deltagreg/OPEN-DELTA/photos/3D Printer 065.JPG

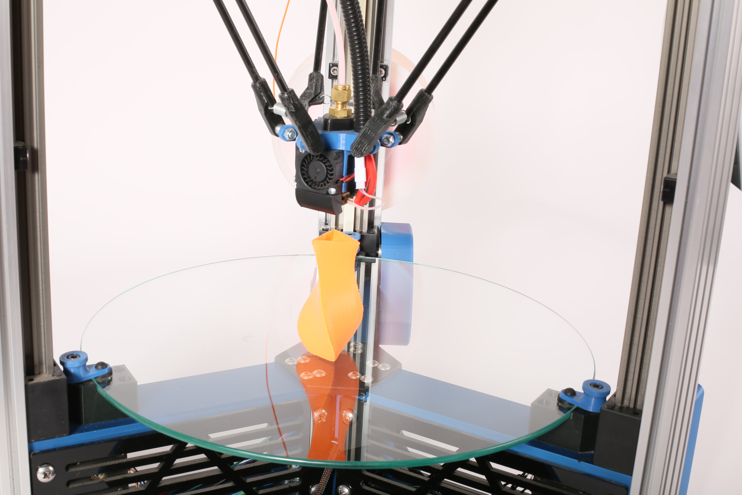
photos/3D Printer 065.JPG
