deltagreg/OPEN-DELTA/photos/3D Printer 059.JPG

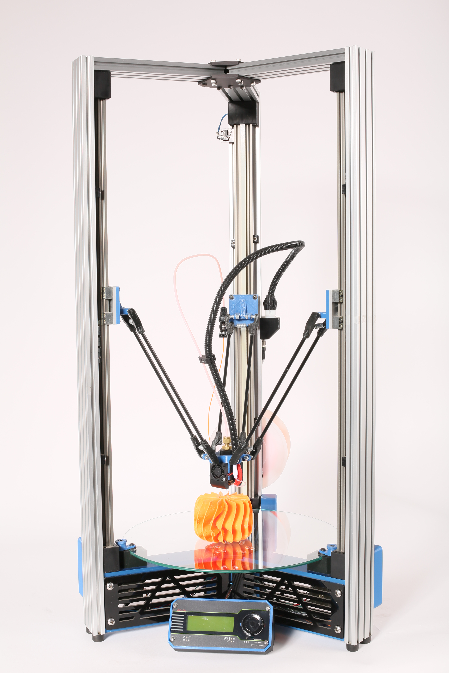
photos/3D Printer 059.JPG
