deltagreg/OPEN-DELTA/README.md

# OPEN-DELTA
DELTA 3D PRINTER 
This is the work of Greg Southerland of TX-RX Labs of Houston. Greg along with a small work group have designed and built a 3-D
printer. This work is being  given to the 3-D Printing community.
