deltagreg/OPEN-DELTA/render/delta_bot_firstPass_4_DOF_beuty0005.JPG

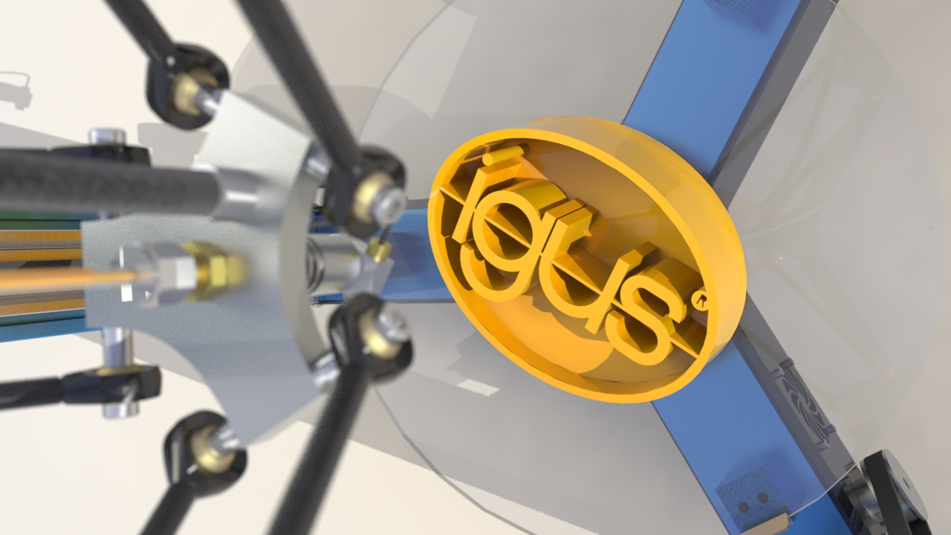
render/delta_bot_firstPass_4_DOF_beuty0005.JPG
