deltagreg/OPEN-DELTA/OPEN SOURCE PRINTER REV_1.xls

Sheet: HARDWARE
 | PARTS
 | DISCRIPTION | SOURCE | PART NUMBER | QT'Y | COMMENTS
MCMASTER-CARR NUMBER
FRAME
LEGS TO BASE MOUNTING SCREW | 5MM X 8MM SOCKET HEAD | MCMASTER-CARR | 91274A103 | 12
LEGS TO BASE MOUNTING NUT | 5MM T-NUT | MISUMI | HNKK5 | 12
TOP FROG TO TOP SCREW | 5MM X 8MM SOCKET HEAD | MCMASTER-CARR | 91274A103 | 18
TOP FROG TO TOP NUT | 5MM T-NUT | MISUMI | HNKK5 | 18
BTM FROG TO TOP SCREW | 5MM X 15MM SOCKET HEAD SCREW | MCMASTER-CARR | 91290A231 | 18
BTM FROG TO TOP NUT | 5MM LOCKNUT | MCMASTER-CARR | 94205A240 | 18
GUIDE PIN | 6MM X 2MM X 3MM DIA. SPACER | MCMASTER-CARR | 94669A700 | 6
GUIDE PIN SCREW | 3MM X 8MM SOCKET HEAD | MCMASTER-CARR | 91274A103 | 6
GUIDE PIN NUT | 3MM LOCK NUT | MCMASTER-CARR | 90576A102 | 6
TOP EXT TO SIDE EXT SCREW | 5MM X 8MM BUTTON HEAD SOCKET CAP SCREW | MCMASTER-CARR | 92137A412 | 6
SIDE PLATE H/WARE TOWARD CENTER | THREAD CERT 1/4"-1/4" THICK | MCMASTER-CARR | 93482A721 | 12
SIDE PLATE H/WARE AWAY FROM CENTER | THREAD CERT 1/4"-1/8" THICK | MCMASTER-CARR | 93482A691 | 12
SIDE TO BASE SCREW | 1/4-20X 3/4" | MCMASTER-CARR | 98164A213 | 24
FEET | 3/4" DIA X 9/16 TALLX 3/16 HOLE | MCMASTER-CARR | 9540K663 | 6
FEET MOUNTING SCREWS | 5MM X 12MM PAN HEAD | MCMASTER-CARR | 91239A228 | 6
RAIL MOTOR
MOTOR MOUNTING H/WARE | 3MM X 6MM SOCKET HEAD | MCMASTER-CARR | 91239A111 | 12
PULLEY | GT2-20 5MM BORE FLANGED 6MM WIDE | EBAY |  | 3
BELT | GT2-97 TOOTH 6MM WIDE | MUSIMI USA |  | 3
LINEAR RAIL
WHEEL AXIALS | 5MM X 30MM PAN HEAD | MCMASTER-CARR | 91239A236 | 9
WHEEL CENTER SPACERS | 5MM ID 10MM OD X 1MM THK SHIM | MCMASTER-CARR | 98089A375 | 9
WHEEL TO CARRIAGE SPACER | 5MM ID 10MM OD X 1MM THK SHIM | MCMASTER-CARR | 98089A375 | 9
WHEEL BEARINGS | FLANGED BEARING | EBAY | F605ZZ | 18
BELT CLIP SCREWS | 3MM X 12MM SOCKET HEAD | MCMASTER-CARR | 91290A117 | 12
BELT CLIP NUTS | 3MM NUT | MCMASTER-CARR | 91828A211 | 12
WHEEL TENSION ADJUSTMENT SCREW | 3MM X 25MM SOCKET HEAD | MCMASTER-CARR | 91290A125 | 3
WHEEL TENSION ADJUSTMENT NUT | 3MM SQUARE NUT |  |  | 3
IDLER BEARING | FLANGED BEARING F625ZZ | EBAY | F625ZZ | 6
IDLER SHAFT | 5MMX 50MM | MCMASTER-CARR | 6112K37 | 3
DRIVE SHAFT | 5MMX 70MM | MCMASTER-CARR | 6112K37 | 3
DRIVE PULLEY | GT2-36 5MM BORE FLANGED 6MM WIDE | EBAY |  | 3
CARRIAGE BELT PULLEY | GT2-26 5MM BORE FLANGED 9MM WIDE | MISUMI | GPA26GT2090-A-H5 | 3
BELT | GT2-1800 9MM WIDE | EBAY |  | 3
SPRING FOR BELT TENSION | SPRING #89U 7/16 OD, 3/4 LG, .048DIA wire | SERVALITE | hillman group | 2
RAIL | NFSF5-2040-798MM | MISUMI |  | 3
RAIL MOUNTING | 5MMX 12MM SOSKET HEAD | MCMASTER-CARR | 91290A228 | 12
RAIL T0 SIDE | 5MM X 35MM SOCKET HEAD | MCMASTER-CARR | 91239A256 | 12
T-NUTS | 5MM T-NUT | MISUMI | HNKK5 | 12
BEARING | 14MM x 5MM x 5MM BORE | EBAY |  | 9
PLANCHETTE
J-HEAD | J-HEAD | HOTENDS.COM | MK-V BV | 1 | DRILL 3MM HOLE FOR THERMISTER
J-HEAD /BT MOUNTING H/WARE SCREW | 3MM X 25 SOCKET HEAD | MCMASTER-CARR | 91290A125 | 2
J-HEAD /BT MOUNTING H/WARE NUT | 3MM LOCK NUT | MCMASTER-CARR | 90576A102 | 2
BOWDEN TUBE FITTING | 4MM BULKHEAD TUBE FITTING MODIFIED | SWEDGELOK | BB-4MO-61 | 1 | CUT TO 27mm total length
FILAMENT FAN MOUNTING H/WARE | 2.9MM X 6.5MM #1 DRIVE | MCMASTER-CARR | 94997A225 | 8
BARREL FAN MOUNTING H/WARE | 2.9MM X 13MM #1 DRIVE | MCMASTER-CARR | 94997A275 | 4
BOWDEN TUBE | 4MM X DDDMM | EBAY |  |  | 30"
ELECT TUBE | 3/8" CORRUGATED TUBING .5" OD | MCMASTER-CARR | 7840K72 | 5'? | CUT TO 30"
ARMS
SPRINGS | SPRING #74 5/16 OD, 1-3/16 LG,.035DIA | SERVALITE | hillman group | 12 | ebay
ARM RODS | CARBON FIBER SPAR .24"DIA 32.5" LNG | GOODWINS.COM | 20010 | 2 | CUT TO 260MM
BALL STUD | 5MM THREAD BALL STUD 8MM DIA BALL | SPRINGFIX LINKAGES | M 2662 | 12
BALL STUD MOUNTING H/WARE | 5MM LOCKNUT | MCMASTER-CARR | 94205A240 | 12
HOME SWITCHES
MOUNTING HARDWARE | 5MM X 10MM SOCKET HEAD SCREW | MCMASTER-CARR | 91290A224 | 3
CIRCUIT BOARD MOUNTING H/WARE SCREW | 3MM X 8MM SOCKET HEAD SCREW | MCMASTER-CARR | 91290A113 | 3
CIRCUIT BOARD MOUNTING H/WARE THREAD CERT | 3MM THREAD CERT 3.8MM LNG | MCMASTER-CARR | 94180A331 | 3
GLASS HOLD DOWN (FSR)
HINGE AXIAL | 5MM X 35MM SOCKET HEAD SCREW | MCMASTER-CARR | 91290A256 | 3
AXAL NUT | 5MM LOCKNUT | MCMASTER-CARR | 94205A240 | 3
BUMPER
BUMPER SCREW | 5MM X 15MM SOCKET HEAD SCREW | MCMASTER-CARR | 91274A125 | 3
BUMPER NUT | 5MM LOCKNUT | MCMASTER-CARR | 94205A240 | 3
CAM SPACER | 5MM ID 8MM OD 8MM LG | MCMASTER-CARR | 93295A551 | 3
CAM AXAIL | 5MM X 18MM SOCKET HEAD SCREW | MCMASTER-CARR | 91290A238 | 3
MOUNTING H/WARE SCREW | 5MM X 15MM SOCKET HEAD SCREW | MCMASTER-CARR | 91274A125 | 6
MOUNTING H/WARENUT | 5MM LOCKNUT | MCMASTER-CARR | 94205A240 | 6
POWER SUPPLY/SWITCH
SWITCH MOUNTING H/WARE | 4MM X 5MM SOCKET HEAD SCREW | MCMASTER-CARR | 91274A113 | 2
END CAP MOUNTING H/WARE | 4MM X 5MM SOCKET HEAD SCREW | MCMASTER-CARR | 91274A113 | 2
RETAINER SCREWS | 3MM X 16MM SOCKET HEAD SCREW | MCMASTER-CARR | 95263A158 | 2
RETAINER NUTS | 3MM LOCK NUT | MCMASTER-CARR | 90576A102 | 2
SWITCH SCREWS | 4MM X 8MM FLAT HEAD SCREW | MCMASTER-CARR | 91263A827 | 2
SWITCH NUTS | 4MM LOCK NUT | MCMASTER-CARR | 90576A103 | 2
FEET SCREWS | 5MM X 15MM SOCKET HEAD SCREW | MCMASTER-CARR | 91274A125 | 4
NUT CERT | 5MM THREAD CERT | MCMASTER-CARR | 94180A361 | 2
PRINTER SWITCH
PLUG MOUNTING H/WARE | 2.9MM X 6.5MM #1 DRIVE | MCMASTER-CARR | 94997A225 | 2
CASE MOUNTING H/WARE TOP SCREWS | 5MM X 8MM SOCKET HEAD | MCMASTER-CARR | 91274A103 | 2
CASE MOUNTING H/WARE BTM SCREW | 5MM X 30MM SOCKET HEAD | MCMASTER-CARR | 91290A254 | 1
CASE MOUNTING T-NUT | 5MM T-NUT | MISUMI | HNKK5 | 3
ELECTRONICS
E BOARD SPACER TO SIDE PLATE SCREW | 3MM X 5MM SOCKET HEAD | MCMASTER-CARR | 91274A101 | 4
THREADED SPACER | 3MM X 6MM ALUM. THREADED SPACER | MCMASTER-CARR | 95947A110 | 4
E BOARD MOUNTING TO SPACER SCREW | 3MM X 4MM PAN HEAD | MCMASTER-CARR | 92000A113 | 4
DISPLAY
CASE MOUNTING H/WARE SCREW | 5MM X 8MM SOCKET HEAD | MCMASTER-CARR | 91274A103 | 2
CASE MOUNTING THREAD CERT | 5MM THREAD CERT | MCMASTER-CARR | 94180A361 | 2
DISPLAY MOUNTING H/WARE | 2.9MM X 6.5MM #1 DRIVE | MCMASTER-CARR | 94997A225 | 4 | MODIFY FOR 3MM THRD CERT?
ELECT TUBE | 3/8" CORRUGATED TUBING .5" OD | MCMASTER-CARR | 7840K72 |  | CUT TO 100mm
FILAMENT FEEDER
MOUNTING H/WARE SCREW | 5MM X 8MM SOCKET HEAD | MCMASTER-CARR | 91274A103 | 2
MOUNTING H/WARE T-NUT | 5MM T-NUT | MISUMI | HNKK5 | 2 | openbuilds $ .20
SPRING | .375 OD X 1" .035 DIA | MCMASTER-CARR | 9657K306 | 1
KNOB | 1/16-18 BRASS THUMB NUT | MCMASTER-CARR | 92741A170 | 1
ADJUSTMENT SCREW | 5/16-18 1-1/2"LG CAP SCREW | MCMASTER-CARR | 91309A587 | 1
MK-7 KNURLED GEAR | MK-7 F- DRIVE GEAR 5MM BORE 1.75 | EBAY |  | 1 | $3.70
MOTOR MOUNTING BOLTS | 3MM X 30MM LG | MCMASTER-CARR | 91290A130 | 4
BEARING | 16MM X 5MM BORE 5MM THICK | EBAY | 605ZZ | 1
BEARING AXAL | 5MM X 12MM | MCMASTER-CARR | 91290A228 | 1
AXAL NUT | 5MM T-NUT | MISUMI | HNKK5 | 1
BEARING SPACERS | 5MM ID 10MM OD X 1MM THK SHIM | MCMASTER-CARR | 98089A375 | 2
HOTEND PLUG
PLUG BOX MOUNTING H/WARE SCREW | 5MM X 8MM SOCKET HEAD | MCMASTER-CARR | 91274A103 | 2
PLUG BOX MOUNTING H/WARE T-NUT | 5MM T-NUT | MISUMI | HNKK5 | 2
CONDUIT HEADSHELL SCREW | 3MM X 6MM SOCKET HEAD SCREW | MCMASTER-CARR | 91239A111 | 2
CONDUIT HEADSHELL NUT | 3MM NUT | MCMASTER-CARR | 91828A211 | 2
BELT GUARD
MOUINTING SCREWS | 5MM X 8MM SOCKET HEAD | MCMASTER-CARR | 91274A103 | 6
MOUNTING H/WARE T-NUT | 5MM T-NUT | MISUMI | HNKK5 | 6
REEL HOLDER
MOUINTING SCREWS | 5MM X 8MM SOCKET HEAD | MCMASTER-CARR | 91274A103 | 2
MOUNTING H/WARE T-NUT | 5MM T-NUT | MISUMI | HNKK5 | 6
 | McMASTER CARR |  |  | REQ'D/1 | QT'Y PER UNIT | COST/UNIT | GROSS UNITS/# OF PEOPLE | TOTAL COST
 | 1/4-20X 3/4" SOCKET HEAD SCREW | MCMASTER-CARR | 98164A213 | 24 | 25 | 9.81 | 8 | 78.48
 | 2.9MM X 13MM #1 DRIVE | MCMASTER-CARR | 94997A275 | 4 | 100 | 12.34 | 1 | 12.34
 | 2.9MM X 6.5MM #1 DRIVE | MCMASTER-CARR | 94997A225 | 14 | 100 | 11.8 | 2 | 23.60
 | 3/8" CORRUGATED TUBING .5" OD | MCMASTER-CARR | 7840K72 | 0 | 5' | 2.52 | 8 | 20.16
 | 3MM LOCK NUT | MCMASTER-CARR | 90576A102 | 10 | 100 | 3.27 | 1 | 3.27
 | 3MM NUT | MCMASTER-CARR | 91828A211 | 14 | 100 | 5.55 | 2 | 11.10
 | 3MM THREAD CERT 3.8MM LNG | MCMASTER-CARR | 94180A331 | 3 | 100 | 12.3 | 1 | 12.30
 | 3MM X 4MM PAN HEAD | MCMASTER-CARR | 92000A113 | 4 | 100 | 5.52 | 1 | 5.52
 | 3MM X 5MM SOCKET HEAD | MCMASTER-CARR | 91274A101 | 4 | 50 | 4.35 | 1 | 4.35
 | 3MM X 6MM SOCKET HEAD | MCMASTER-CARR | 91239A111 | 14 | 100 | 6.88 | 2 | 13.76
 | 3MM X 8MM SOCKET HEAD SCREW | MCMASTER-CARR | 91290A113 | 3 | 100 | 6.58 | 1 | 6.58
 | 3MM X 12MM SOCKET HEAD | MCMASTER-CARR | 91290A117 | 12 | 100 | 7.75 | 1 | 7.75
 | 3MM X 16MM SOCKET HEAD SCREW | MCMASTER-CARR | 95263A158 | 2 | 25 | 3.9 | 1 | 3.90
 | 3MM X 25MM SOCKET HEAD | MCMASTER-CARR | 91290A125 | 5 | 100 | 11.92 | 1 | 11.92
 | 3MM X 30MM SOCKET HEAD | MCMASTER-CARR | 91290A130 | 4 | 100 | 9.96 | 1 | 9.96
 | 4MM LOCK NUT | MCMASTER-CARR | 90576A103 | 2 | 100 | 3.9 | 1 | 3.90
 | 4MM X 5MM SOCKET HEAD SCREW | MCMASTER-CARR | 91274A113 | 4 | 50 | 6.63 | 1 | 6.63
 | 4MM X 6MM FLAT HEAD SCREW | MCMASTER-CARR | 91263A826 | 2 | 100 | 6.31 | 1 | 6.31
 | 3MM X 6MM ALUM. THREADED SPACER | MCMASTER-CARR | 95947A110 | 4 | 1 | 0.46 | 32 | 14.72
 | 5MM ID 10MM OD X 1MM THK SHIM | MCMASTER-CARR | 98089A375 | 20 | 25 | 7.21 | 7 | 50.47
 | 5MM LOCKNUT | MCMASTER-CARR | 94205A240 | 42 | 50 | 6.09 | 7 | 42.63
 | 5MM THREAD CERT | MCMASTER-CARR | 94180A361 | 2 | 50 | 11.43 | 1 | 11.43
 | 5MM X 8MM SOCKET HEAD SCREW | MCMASTER-CARR | 91274A103 | 50 | 100 | 9.55 | 4 | 38.20
 | 5MM X 10MM SOCKET HEAD SCREW | MCMASTER-CARR | 91290A224 | 3 | 100 | 9.55 | 1 | 9.55
 | 5MM X 12MM SOCKET HEAD | MCMASTER-CARR | 91290A228 | 13 | 100 | 10.98 | 2 | 21.96
 | 5MM X 15MM SOCKET HEAD SCREW | MCMASTER-CARR | 91290A231 | 18 | 100 | 14.29 | 2 | 28.58
 | 5MM X 18MM SOCKET HEAD SCREW | MCMASTER-CARR | 91290A238 | 3 | 100 | 12.45 | 1 | 12.45
 | 5MM X 30MM PAN HEAD | MCMASTER-CARR | 91239A236 | 9 | 100 | 12.38 | 1 | 12.38
 | 5MM X 30MM SOCKET HEAD | MCMASTER-CARR | 91290A254 | 1 | 50 | 7.99 | 1 | 7.99
 | 5MM X 35MM SOCKET HEAD | MCMASTER-CARR | 91290A256 | 3 | 10 | 10 | 3 | 30.00
 | 5MM X 50MM SHAFT | MCMASTER-CARR | 6112K37 | 6 | 200mm long | 9.02 | 8 | 72.16
 | 5MM X 12MM PAN HEAD | MCMASTER-CARR | 91239A228 | 6 | 100 | 8.12 | 1 | 8.12
 | 5MM ID 8MM OD 8MM LG | MCMASTER-CARR | 93295A551 | 3 | 1 | 1.38 | 24 | 33.12
 | 6MM OD. X 2MM X 3MM ID. SPACER | MCMASTER-CARR | 94669A700 | 6 | 1 | 1.23 | 48 | 59.04
 | THREAD CERT 1/4"-1/4" THICK | MCMASTER-CARR | 93482A721 | 12 | 25 | 8.54 | 4 | 34.16
 | THREAD CERT 1/4"-1/8" THICK | MCMASTER-CARR | 93482A691 | 12 | 25 | 7.53 | 4 | 30.12
 | 1/16-18 BRASS THUMB NUT | MCMASTER-CARR | 92741A170 | 1 | 25 | 7.53 | 1 | 7.53
 | 5/16-18 1-1/2"LG CAP SCREW | MCMASTER-CARR | 91309A587 | 1 | 25 | 7.53 | 1 | 7.53
 |  |  |  |  |  |  | NUMBER OF PEOPLE | PER PERSON
 |  |  |  |  |  |  |  | 613.98
 |  |  |  |  |  |  | 8 | 76.75
 | MISUMI
 | 5MM T-NUT | MISUMI | HNKK5 | 56 | 100 | 20.87 | 20.87
 | LEGS | MISUMI | HFS5-2060-1000 | 3 | 1 | 12.9 | 38.7
 | LINEAR RAIL | MISUMI | HFSF5-2040-800 | 3 | 1 | 9.92 | 29.76
 | TOP | MISUMI | HFS5-2060-225 | 3 | 1 | 3.85 | 11.55
 |  |  |  |  |  |  | 100.88
 | EBAY
 | GT2-20 5MM BORE FLANGED 6MM WIDE |  |  | 3
 | FLANGED BEARING | EBAY | F605ZZ | 18 |  | 0.7 | 12.6
 | FLANGED BEARING F625ZZ | EBAY | F625ZZ | 6 |  | 0.9 | 5.4
 | GT2-36 5MM BORE FLANGED 6MM WIDE | EBAY |  | 3 |  | 3.25 | 9.75
 | GT2-1800 9MM WIDE | EBAY |  | 1 | 2000MM | 10 | 10
 | 4MM X DDDMM TEFLON TUBE | EBAY |  | 1 |  | 5 | 5
 | 14MM x 5MM x 5MM BORE | EBAY | 605ZZ | 9 |  | 0.6 | 5.4
 |  |  |  |  |  |  | 48.15
 |  |  |  |  | HARDWARE | 226.00
 |  |  |  |  | LIMIT SWITCH | 30
 |  |  |  |  | MACHINE | 100
 |  |  |  |  | DISPLAY | 75
 |  |  |  |  | BOARD | 110
 |  |  |  |  | MOTORS | 80
 |  |  |  |  | FANS (4) | 40
 |  |  |  |  | HOT END | 75
 |  |  |  |  | POWER SUPPLY | 40
 |  |  |  |  | MISC ELEC | 50
 |  |  |  |  | TOTAL | 826 | 165.2
 |  |  |  |  | TOTAL + SHIPPING 20% | 991.2
 |  |  |  |  | MISC. 20% | 1156.4

Sheet: 3D PRINTED PARTS
 |  | FILE
 | QT'Y | STL | REV |  | SOLIDWORKS | REV | DXF | REV
FRAME
TOP FROG | 2 | P-FM-001_REV_0 | 0 | P-FM-001_REV_0 |  | 0 | P-FM-001_REV_0 | 0
BOTTOM FROG | 2 | P-FM-002_REV_0 | 0 | P-FM-002_REV_0 |  | 0 | P-FM-002_REV_0 | 0
LINEAR RAIL
DRIVE ENDCAP | 3 | P-LR-001_REV_0 | 0 | P-LR-001_REV_0 | DRIVE_1.SLDPRT | 0 | P-LR-001_REV_0 | 0
DRIVEN ENDCAP | 3 | P-LR-002_REV_0 | 0 | P-LR-002_REV_0 | IDLER_1.SLDPRT | 0 | P-LR-002_REV_0 | 0
CARRIAGE | 3 | P-LR-003_REV_0 | 0 | P-LR-003_REV_0 | CARRIAGE 6 .SLDPRT | 0 | P-LR-003_REV_0 | 0
IDLER SHAFT BLOCK | 3 | P-LR-004_REV_0 | 0 | P-LR-004_REV_0 | JACK BLOCK.SLDPRT | 0 | P-LR-004_REV_0 | 0
MAG HOLDER | 3 | P-LR-005_REV_0 | 0 | P-LR-005_REV_0 | MAG HOLDER.SLDPRT | 0 | P-LR-005_REV_0 | 0
BELT RETAINER | 3 | P-LR-006_REV_0 | 0 | P-LR-006_REV_0 | CLET_2 | 0 | P-LR-006_REV_0 | 0
PLANCHETTE
PLANCHETTE | 1 | P-PL-001_REV_0 | 0 | P-PL-001_REV_0 | PLANCHETTEV6.SLDPRT | 0 | P-PL-001_REV_0 | 0
J-HEAD MOUNT | 1 | P-PL-002_REV_1 | 1 | P-PL-002_REV_1 | J-HEADMOUNT_REV3.SLDPRT | 1 | P-PL-002_REV_0 | 1
ARMS
ROD ENDS | 12 | P-AM-01_REV_0 | 0 | P-AM-01_REV_0 | BS ROD.SLDPRT | 0 | P-AM-01_REV_0 | 0
HOME SWITCHES
CASE | 3 | P-HS-001_REV_0 | 0 | P-HS-001_REV_0 | LIMIT SWITCH HE.SLDPRT | 0 | P-HS-001_REV_0 | 0
GLASS HOLD DOWN
HINGE BOTTOM | 3 | P-GL-001_REV_0 | 0 | P-GL-001_REV_0 | BOTTOM GLASS.SLDPRT | 0 | P-GL-001_REV_0 | 0
HINGE TOP | 3 | P-GL-002_REV_0 | 0 | P-GL-002_REV_0 | TOP GLASS .SLDPRT | 0 | P-GL-002_REV_0 | 0
CAM | 3 | P-GL-003_REV_0 | 0 | P-GL-003_REV_0 | CAM.SLDPRT | 0 | P-GL-003_REV_0 | 0
POWER SUPPLY
END CAP W/O SWITCH | 1 | P-PS-001_REV_0 | 0 | P-PS-001_REV_0 | POWER SUPPLY NON-SWITCH.SLDPRT | 0 | P-PS-001_REV_0 | 0
END CAP W/SWITCH | 1 | P-PS-002_REV_0 | 0 | P-PS-002_REV_0 | POWER SUPPLY SWITCH.SLDPRT | 0 | P-PS-002_REV_0 | 0
STRAIN RELIEF | 1 | P-PS-003_REV_0 | 0 | P-PS-003_REV_0 | STRAIN RELIEF.SLDPRT | 0 | P-PS-003_REV_0 | 0
FEET | 1 | P-PS-004_REV_0 | 0 | P-PS-004_REV_0 |  | 0 | P-PS-004_REV_0 | 0
PRINTER SWITCH |  |  | 0
SWITCH ENCLOSURE | 1 | P-PR-001_REV_0 | 0 | P-PR-001_REV_0 | ELECT BOX_3.SLDPRT | 0 | P-PR-001_REV_0 | 0
DISPLAY
CASE | 1 | P-DS-001_REV_0 | 0 | P-DS-001_REV_0 | DISPLAY CASE.SLDPRT | 0 | P-DS-001_REV_0 | 0
BEZZEL | 1 | P-DS-002_REV_0 | 0 | P-DS-002_REV_0 | BHEZEL_2.SLDPRT | 0 | P-DS-002_REV_0 | 0
 |  |  | 0 |  |  | 0 |  | 0
FILLAMENT FEEDER |  |  | 0 |  |  | 0 |  | 0
FILLAMENT FEEDER RT SIDE | 1 | P-FF-001_REV_0 | 0 | P-FF-001_REV_0 | RIGHT PUSHER.SLDPRT | 0 | P-FF-001_REV_0 | 0
BEARING YOLK | 1 | P-FF-002_REV_0 | 0 | P-FF-002_REV_0 | YOLK PUSHER.SLDPRT | 0 | P-FF-002_REV_0 | 0
FILLAMENT FEEDER LT SIDE |  | P-FF-003_REV_0 | 0 | P-FF-003_REV_0 | PUSHER_3.SLDPRT | 0 | P-FF-003_REV_0 | 0
 |  |  | 0 |  |  | 0 |  | 0
BELT GUARD |  |  | 0 |  |  | 0 |  | 0
BELT GUARD RT | 2 | P-BG-001_REV_0 | 0 | P-BG-001_REV_0 | BELT GUARD REV.2.SLDPRT | 0 | P-BG-001_REV_0 | 0
BELT GUARD LT | 1 | P-BG-002_REV_0 | 0 | P-BG-002_REV_0 | LEFT BELT GUARD REV 2.SLDPRT | 0 | P-BG-002_REV_0 | 0
 |  |  | 0 |  |  | 0 |  | 0
REEL HOLDER |  | P-RH-001_REV_0 | 0 | P-RH-001_REV_0 | P-RH-001_REV_0 | 0 | P-RH-001_REV_0 | 0
 |  |  | 0 |  |  | 0 |  | 0
HOTEND PLUG |  |  | 0 |  |  | 0 |  | 0
MOLLEX CONNECTION BOX | 1 | P-HP-001_REV_0 | 0 | P-HP-001_REV_0 |  | 0 | P-HP-001_REV_0 | 0
HEADSHELL A | 1 | P-HP-002_REV_0 | 0 | P-HP-002_REV_0 |  | 0 | P-HP-002_REV_0 | 0
HEADSHELL B | 1 | P-HP-003_REV_0 | 0 | P-HP-003_REV_0 |  | 0 | P-HP-003_REV_0 | 0

Sheet: ELECTRONICS
 | PARTS |  | DWG |  | CIRCUIT BOARD FILES
 | DISCRIPTION | SOURCE | DXF | REV | TOP LAYER |  | BOTTOM LAYER | REV | TOP SOLDER MSK | REV | BTM SOLDER MSK | REV | TOP SLK SCREEN | REV | BTM SLK SCREEN | REV | BOARD OUTLINE | REV | DRILLS | REV
 |  |  |  |  | .GLT | REV | .GBL | REV | .GTS | REV | .GBS | REV | .GTO | REV | .GBO | REV | .GKO | REV | .XLN | REV
HOT END
HEATER | 40 WATT 24VDC | EBAY
THERMISTER | EPCOS B57560G104F.THREADED 3MM | EBAY
HOME SWITCHES
CAPICITORS | 4.7 NF
LED REGULATOR | AL5809-15S1-7 | 15A
MOLEX PICOBLADE 3 PIN 1.25MM | 51021-0300 (http://www.newark.com/molex/51021-0300/wire-board-housing-receptacle/dp/57H2315) | newark
MOLEX PICOBLADE 3 PIN 1.25MM | 53048-0310 | newark
MOLEX PICOBLADE 3 PIN 1.25MM | 50079-8100 | newark
CIRCUIT BOARD | OSH PARK |  | E-HE-001_REV_0 | 0
HALL EFFECT SWITCH | TLE4905L
LED RED 5MM
GLASS HOLD DOWN (FSR)
FSR
SWITCH BOARD
POWER SUPPLY
POWER SUPPLY SWITCH | IEC320 | EBAY
PRINTER SWITCH | Cherry CRE22F2BBRLE | CRE22F2BBRLE |  |  | 29mm x 13.5mm
PRINTER PLUG | KYCON 4 PIN PANEL MOUNT |  |  |  | PIN 1 AND 3 ARE (+), PIN 2 AND 4 ARE (-)
PRINTER POWER CABLE | KYCON 4 PIN CONNECTOR | KPPX-4P
POWER SUPPLY | 24VDC 320W
ELECTRONICS
MOTHER BOARD | AZTEEG X3 | panucatt.com | 170
 | AZZTEEG X5 | panucatt.com | 115
 | RAMPS 1.4 | EBAY
DISPLAY
DISPLAY BOARD | VIKKI | panucatt.com | 75,00
HOTEND PLUG
9 PIN MALE/FEMALE | MOLEX .093 | waldom 76650-0055
FILAMENT FEEDER
MOTOR | NEMA 17 MOTOR
ARM MOTORS
MOTOR | NEMA 17 MOTOR | 42BYGHM809 | SPARK FUN | 16.95

Sheet: LASER CUT PARTS
 |  | QT'Y | DRAWING
 |  |  | DXF | REV
BOTTOM SIDES
MOTOR SIDE W/ ELECTRONICS |  | 1
 | AZTEEG X3 BOARD |  | L-SD-001_REV_0 | 0
 | RAMPS 1.4 |  | L-SD-002_REV_0 | 0
 | AZTEEG X5 BOARD |  | L-SD-003_REV_0 | 0
 | RAMBO |  | L-SD-004_REV_0 | 0
MOTOR SIDE W/O ELECTRONICS |  | 2 | L-SD-010_REV_0 | 0
NON MOTOR SIDE |  | 2 | L-SD-011_REV_0 | 0
 |  |  |  | 0
FAN SIDE |  | 1 | L-SD-012_REV_0 | 0
ARM JIG |  |  | L-SD-020_REV_0 | 0

Sheet: MACHINED PARTS
DISCRIPTION | QT'Y | DRAWING
 |  | DXF | REV
FRAME
BOTTOM | 3 | M-FM-001_REV_0 | 0
ENDCAP | 3 | M-FM-002_REV_0 | 0
SIDE MISUMI HFS5-2060-1000 | 3 | M-FM-003_REV_0 | 0
TOP MISUMI HFS5-2060-225 | 3 | M-FM-004_REV_0 | 0
LINEAR RAIL
RAIL HFSF5-2040-800 MISUMI | 3 | M-LR-001_REV_0 | 0
WHEEL | 9 | M-LR-002_REV_0 | 0
RODS | 12 | M-AM-001_REV_0 | 0
