deltagreg/OPEN-DELTA/glass hold down/Assem1.SLDASM

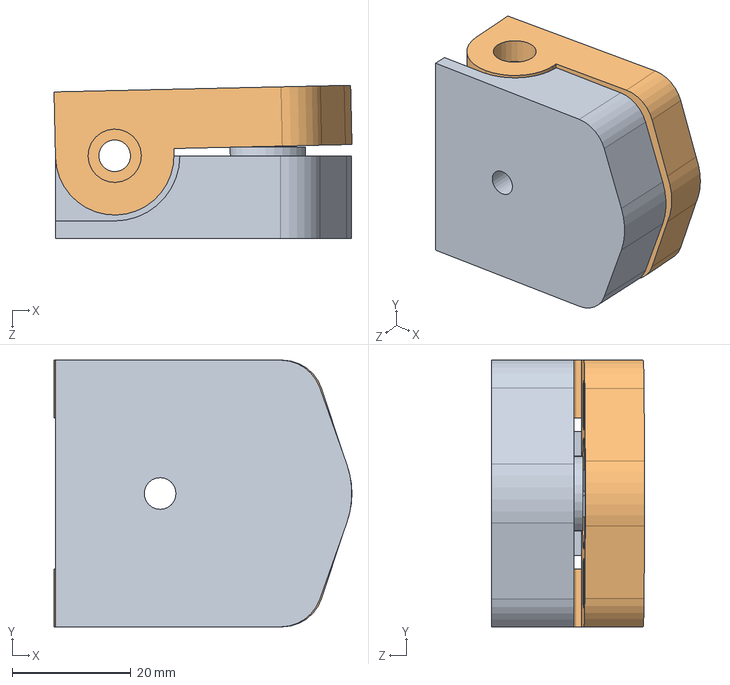
[picture p14: CAD file, 2015-06-23]
glass hold down/Assem1.SLDASM
50.3 x 45.0 x 25.9 mm
P-GL-002_REV_0
P-GL-001_REV_0
