deltagreg/OPEN-DELTA/PUSHER/FF-ASSY.SLDASM

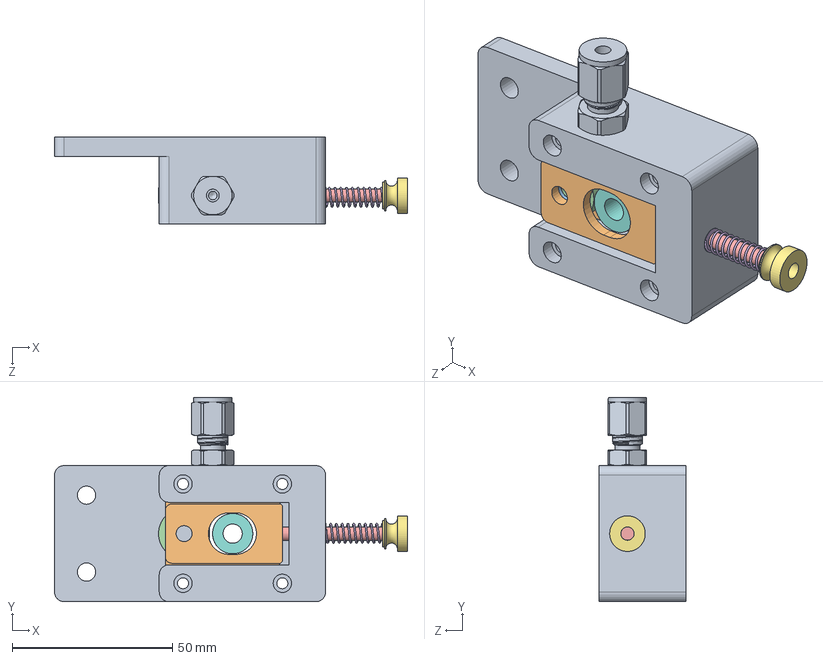
[picture p15: CAD file, 2015-06-23]
PUSHER/FF-ASSY.SLDASM
110.2 x 63.8 x 27.0 mm
P-FF-003_REV_1
P-FF-002_REV_1
washer x 2
pusher bearing
bolt
spring
knob
pusher gear
fitting
