deltagreg/OPEN-DELTA/belt guard/P-BG-002_REV_0.SLDPRT

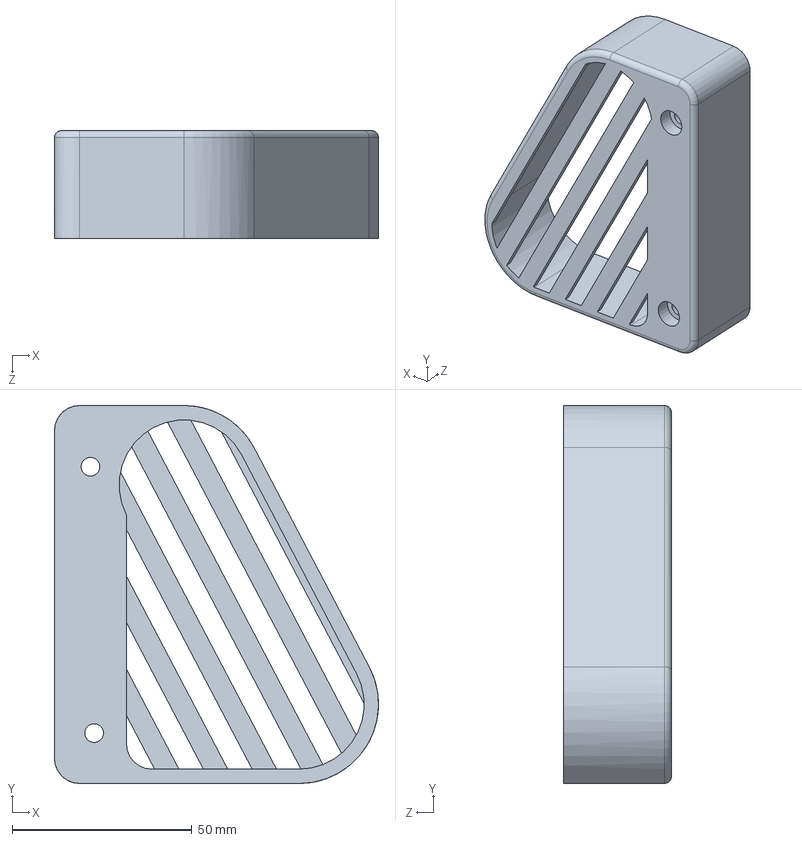
[picture p16: CAD file, 2015-06-23]
belt guard/P-BG-002_REV_0.SLDPRT
90.0 x 105.0 x 30.0 mm
