deltagreg/OPEN-DELTA/display/P-DS-001_REV_0.SLDPRT

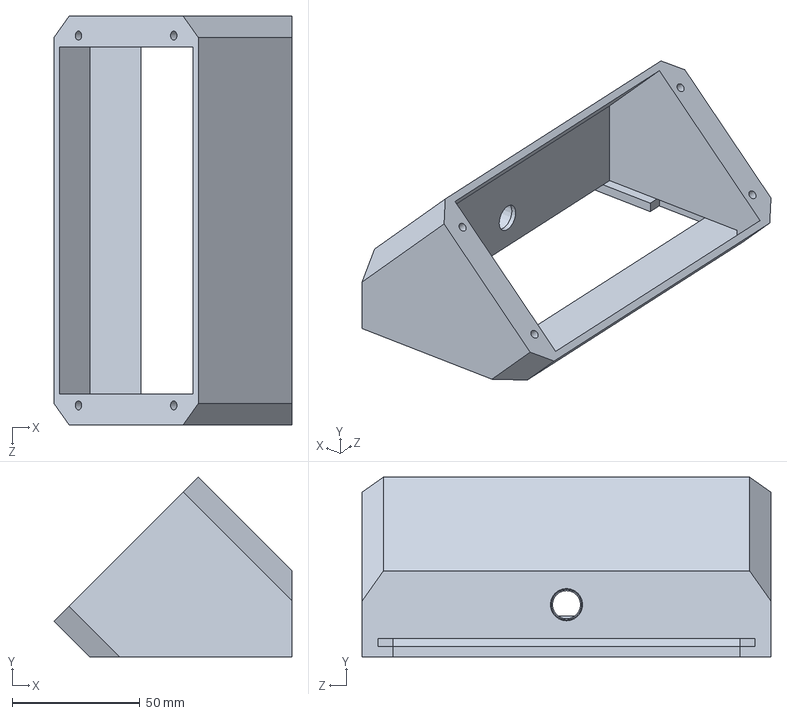
[picture p17: CAD file, 2015-06-23]
display/P-DS-001_REV_0.SLDPRT
93.3 x 70.5 x 160.3 mm
