deltagreg/OPEN-DELTA/END STOP/P-HS-01_REV_0.SLDPRT

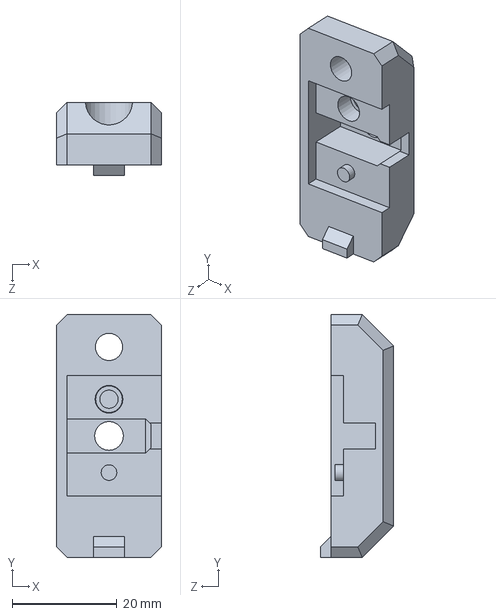
[picture p18: CAD file, 2015-06-23]
END STOP/P-HS-01_REV_0.SLDPRT
20.0 x 46.4 x 14.0 mm
