deltagreg/OPEN-DELTA/glass hold down/P-GL-003_REV_0.SLDPRT

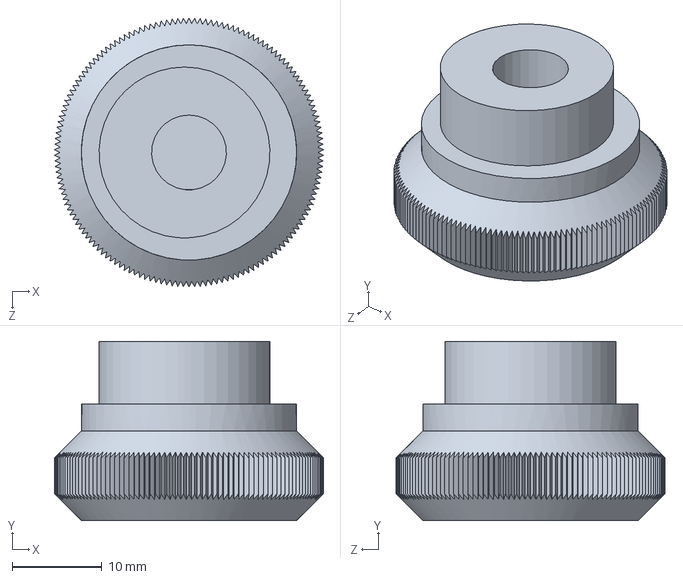
[picture p19: CAD file, 2015-06-23]
glass hold down/P-GL-003_REV_0.SLDPRT
30.0 x 20.0 x 30.0 mm
