deltagreg/OPEN-DELTA/linear rail/P-LR-002_REV_0.SLDPRT

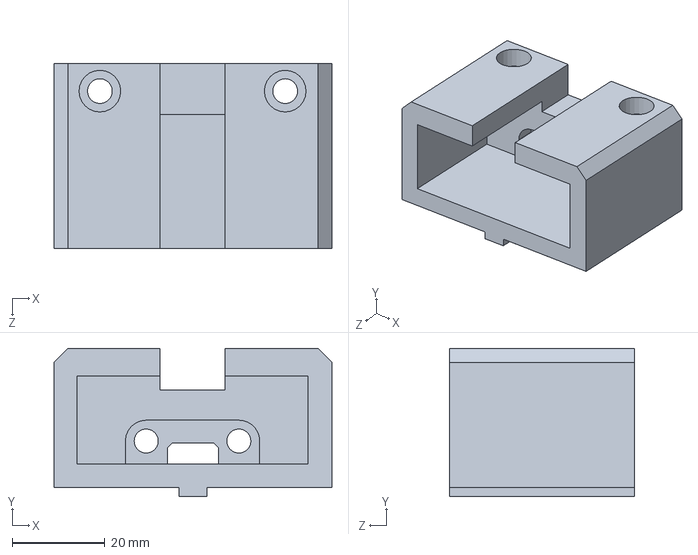
[picture p20: CAD file, 2015-06-23]
linear rail/P-LR-002_REV_0.SLDPRT
60.0 x 32.0 x 40.0 mm
