deltagreg/OPEN-DELTA/planchette/P-PL-002_REV_1.SLDPRT

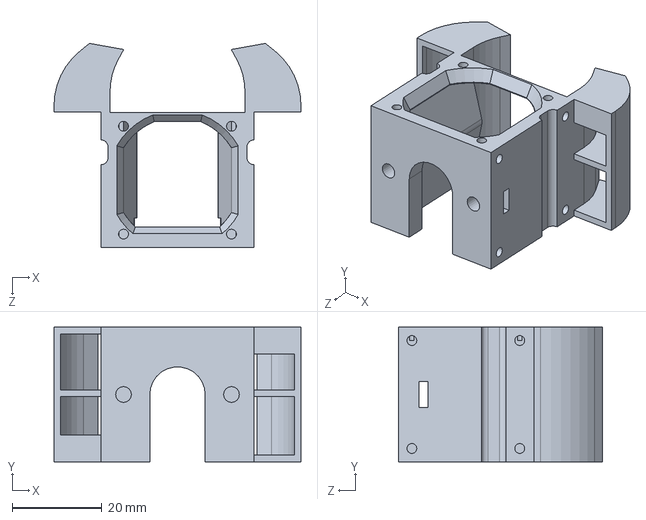
[picture p21: CAD file, 2015-06-30]
planchette/P-PL-002_REV_1.SLDPRT
54.9 x 30.0 x 45.4 mm
