deltagreg/OPEN-DELTA/POWER SUPPLY/P-PS-003_REV_0.SLDPRT

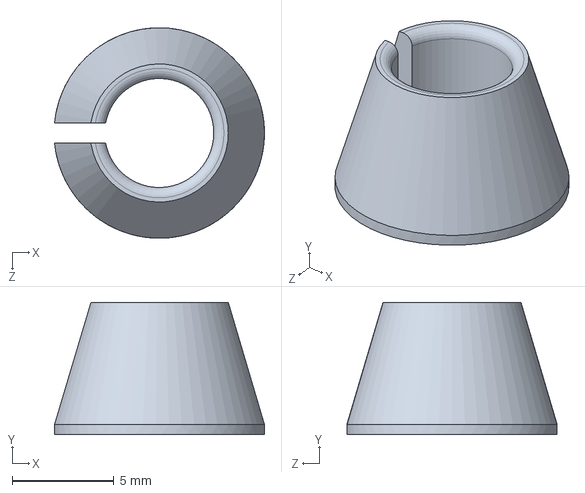
[picture p22: CAD file, 2015-06-23]
POWER SUPPLY/P-PS-003_REV_0.SLDPRT
10.3 x 6.50 x 10.3 mm
