deltagreg/OPEN-DELTA/PUSHER/P-FF-002_REV_0.SLDPRT

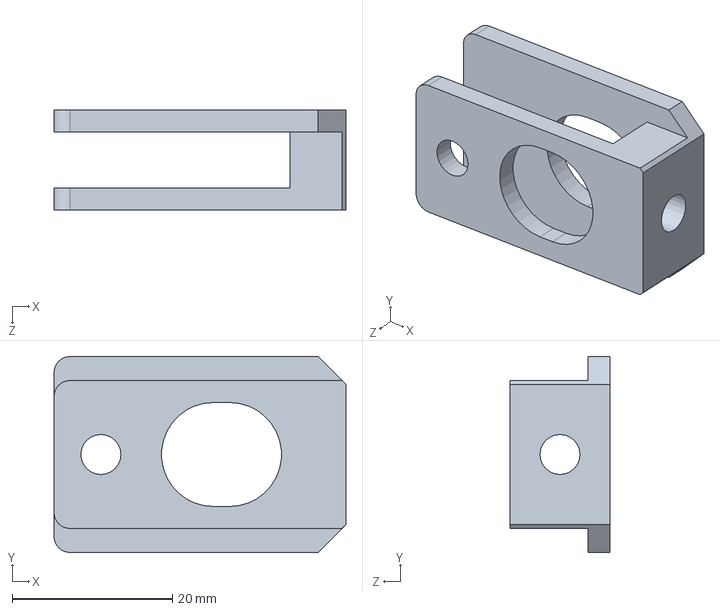
[picture p23: CAD file, 2015-06-23]
PUSHER/P-FF-002_REV_0.SLDPRT
36.5 x 24.5 x 12.5 mm
