deltagreg/OPEN-DELTA/reel post/P-RH-001_REV_0.SLDPRT

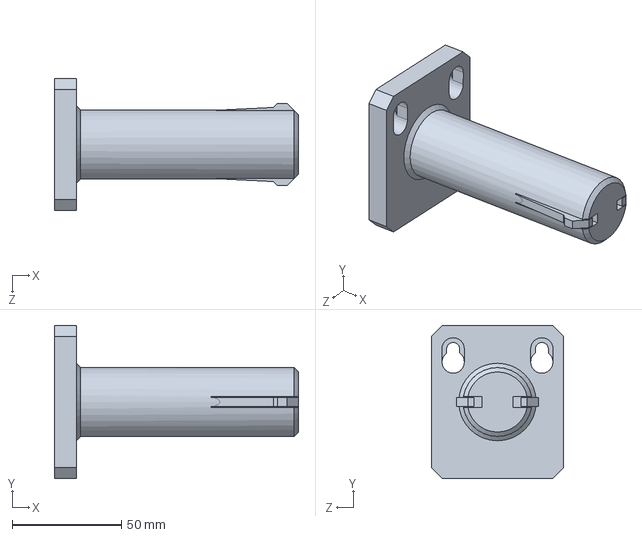
[picture p24: CAD file, 2015-06-23]
reel post/P-RH-001_REV_0.SLDPRT
111.6 x 70.0 x 60.5 mm
