deltagreg/OPEN-DELTA/switch box/P-PR-001_REV_0.SLDPRT

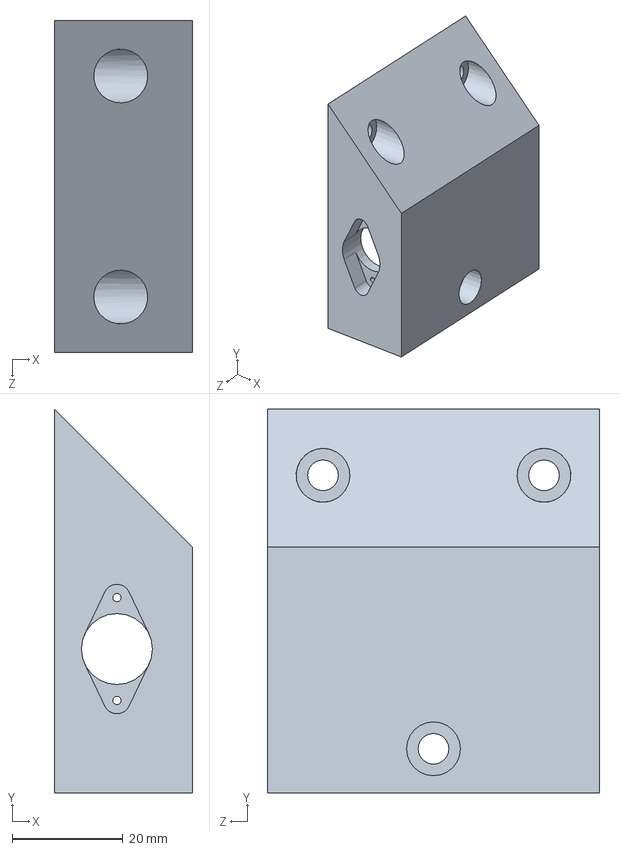
[picture p25: CAD file, 2015-06-23]
switch box/P-PR-001_REV_0.SLDPRT
25.0 x 69.5 x 60.0 mm
