deltagreg/OPEN-DELTA/wire duct/P-HP-003_REV_0.SLDPRT

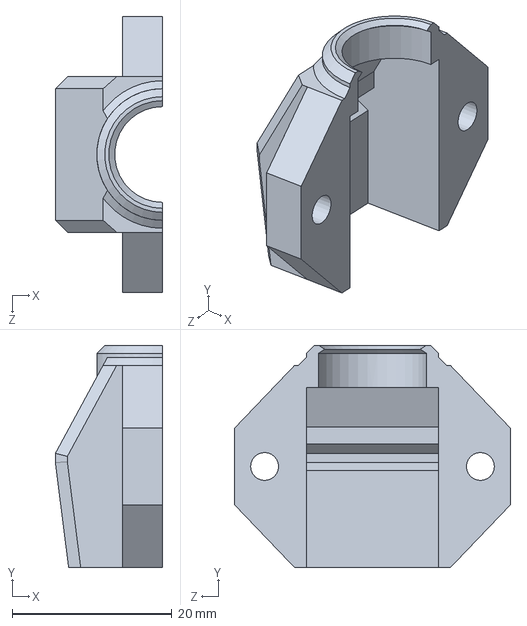
[picture p26: CAD file, 2015-06-23]
wire duct/P-HP-003_REV_0.SLDPRT
13.4 x 27.9 x 34.6 mm
