deltagreg/OPEN-DELTA/display/P-DS-002_REV_0.SLDPRT

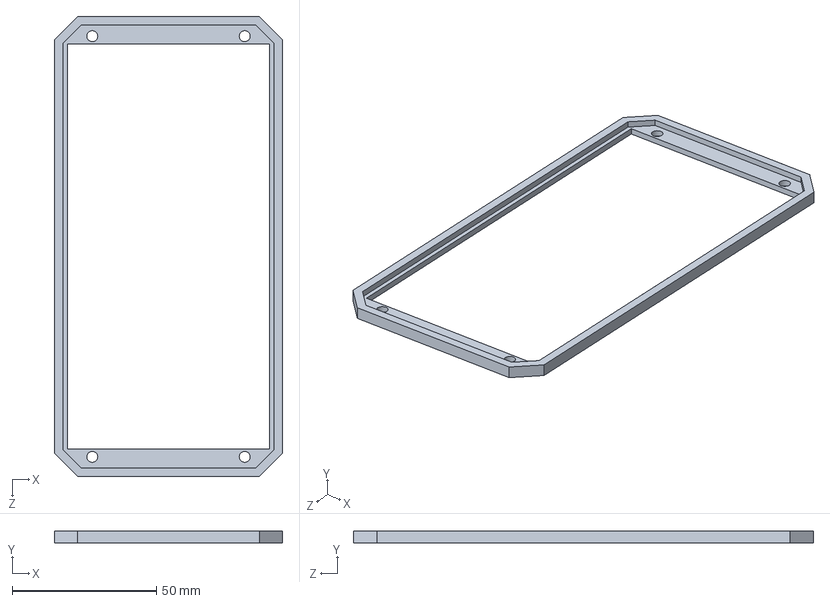
[picture p27: CAD file, 2015-06-23]
display/P-DS-002_REV_0.SLDPRT
79.2 x 4.00 x 159.4 mm
