deltagreg/OPEN-DELTA/linear rail/P-LR-006_REV_0.SLDPRT

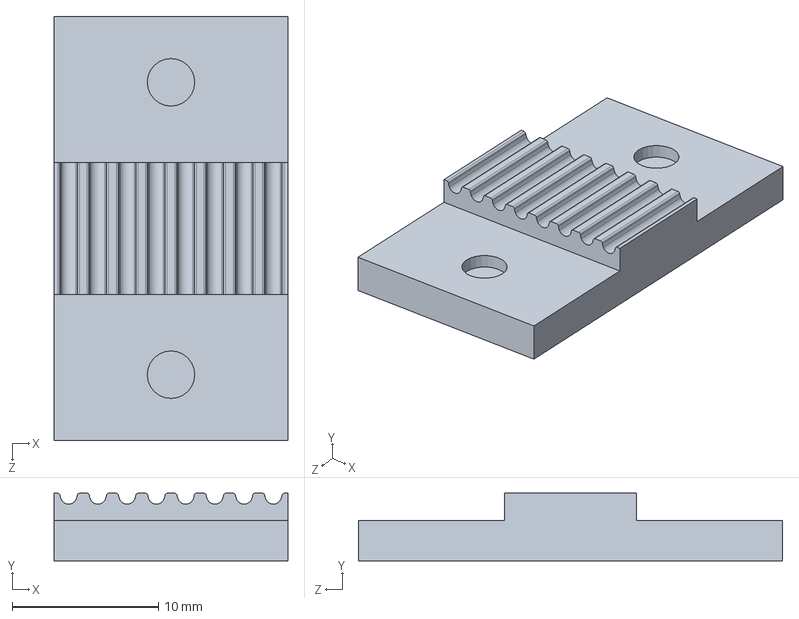
[picture p28: CAD file, 2015-06-23]
linear rail/P-LR-006_REV_0.SLDPRT
16.0 x 4.62 x 29.0 mm
