deltagreg/OPEN-DELTA/planchette/P-PL-001_REV_0.SLDPRT

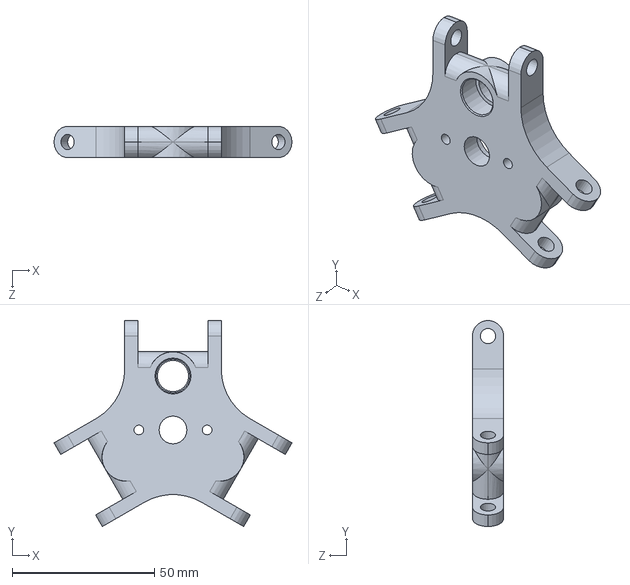
[picture p29: CAD file, 2015-06-23]
planchette/P-PL-001_REV_0.SLDPRT
83.7 x 72.5 x 11.0 mm
