deltagreg/OPEN-DELTA/POWER SUPPLY/P-PS-004_REV_0.SLDPRT

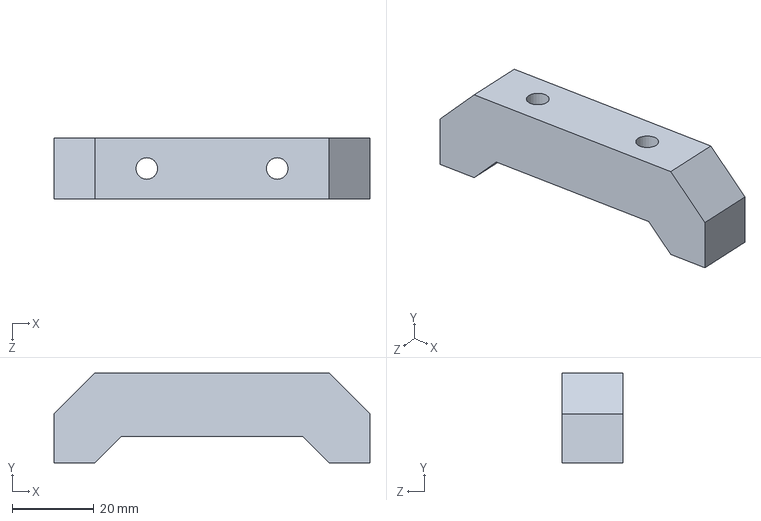
[picture p30: CAD file, 2015-06-23]
POWER SUPPLY/P-PS-004_REV_0.SLDPRT
77.5 x 22.0 x 15.0 mm
