deltagreg/OPEN-DELTA/PUSHER/P-FF-003_REV_0.SLDPRT

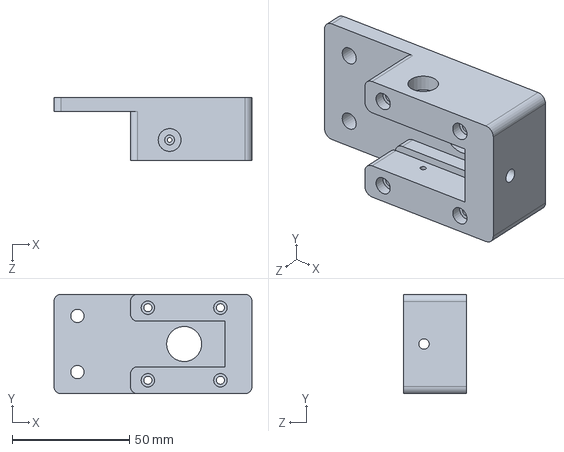
[picture p31: CAD file, 2015-06-23]
PUSHER/P-FF-003_REV_0.SLDPRT
84.6 x 42.5 x 27.0 mm
