deltagreg/OPEN-DELTA/rods/P-AM-01_REV_0.SLDPRT

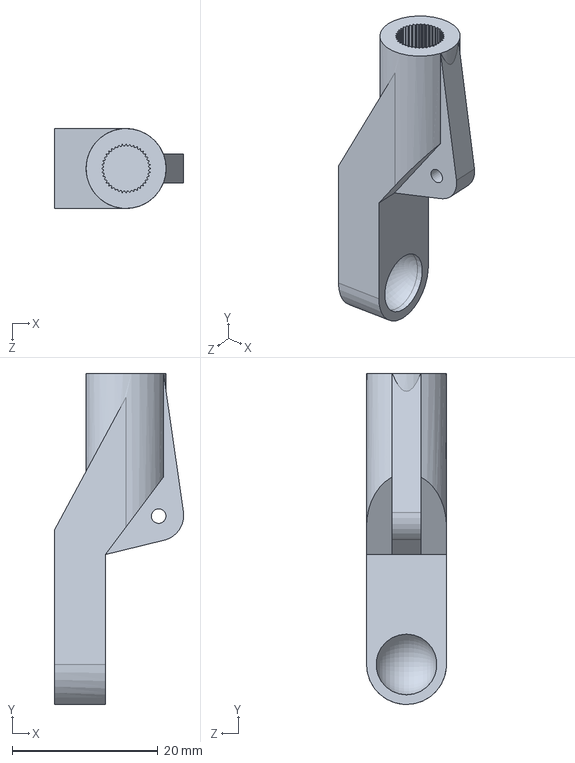
[picture p32: CAD file, 2015-06-23]
rods/P-AM-01_REV_0.SLDPRT
17.8 x 45.5 x 11.0 mm
