deltagreg/OPEN-DELTA/glass hold down/P-GL-002_REV_0.SLDPRT

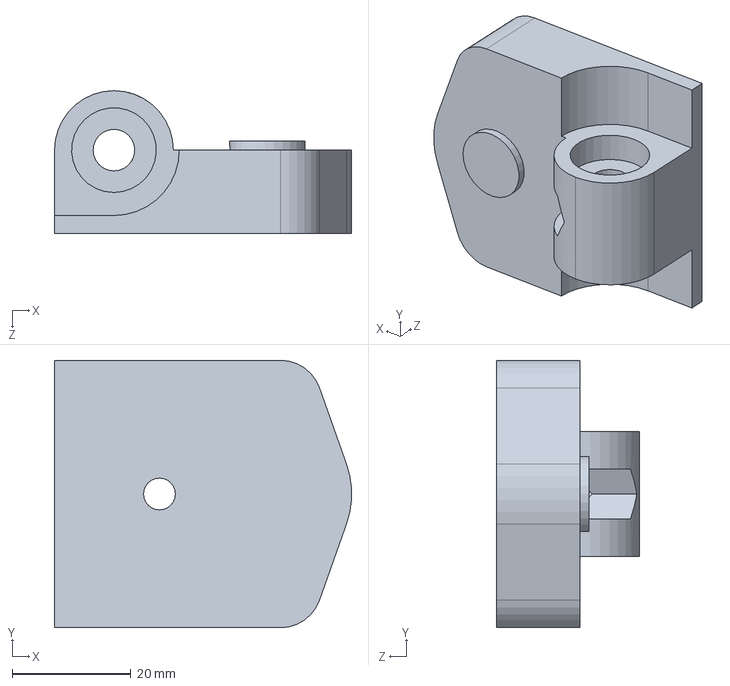
[picture p33: CAD file, 2015-06-23]
glass hold down/P-GL-002_REV_0.SLDPRT
50.0 x 45.0 x 24.0 mm
