deltagreg/OPEN-DELTA/wire duct/P-HP-001_REV_0.SLDPRT

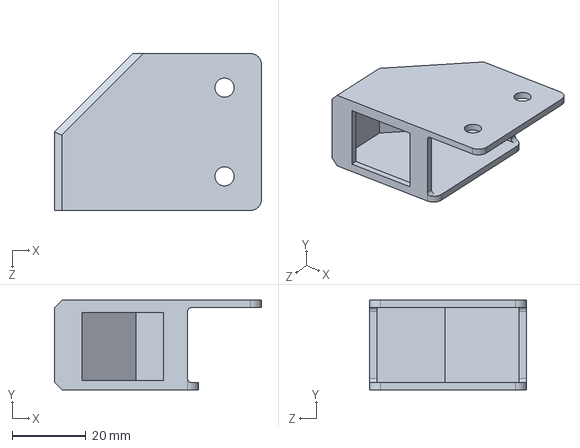
[picture p35: CAD file, 2015-06-23]
wire duct/P-HP-001_REV_0.SLDPRT
56.0 x 24.2 x 42.5 mm
