deltagreg/OPEN-DELTA/frame/P-FM-002_REV_0.SLDPRT

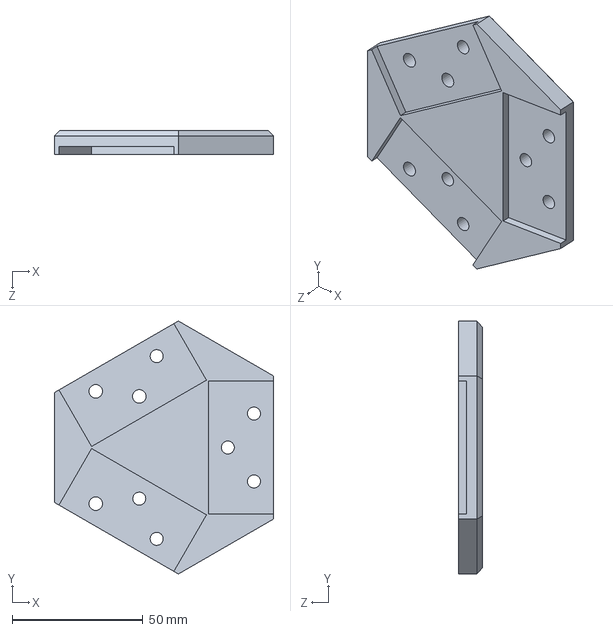
[picture p36: CAD file, 2015-06-23]
frame/P-FM-002_REV_0.SLDPRT
83.9 x 96.9 x 9.00 mm
