deltagreg/OPEN-DELTA/glass hold down/P-GL-001_REV_0.SLDPRT

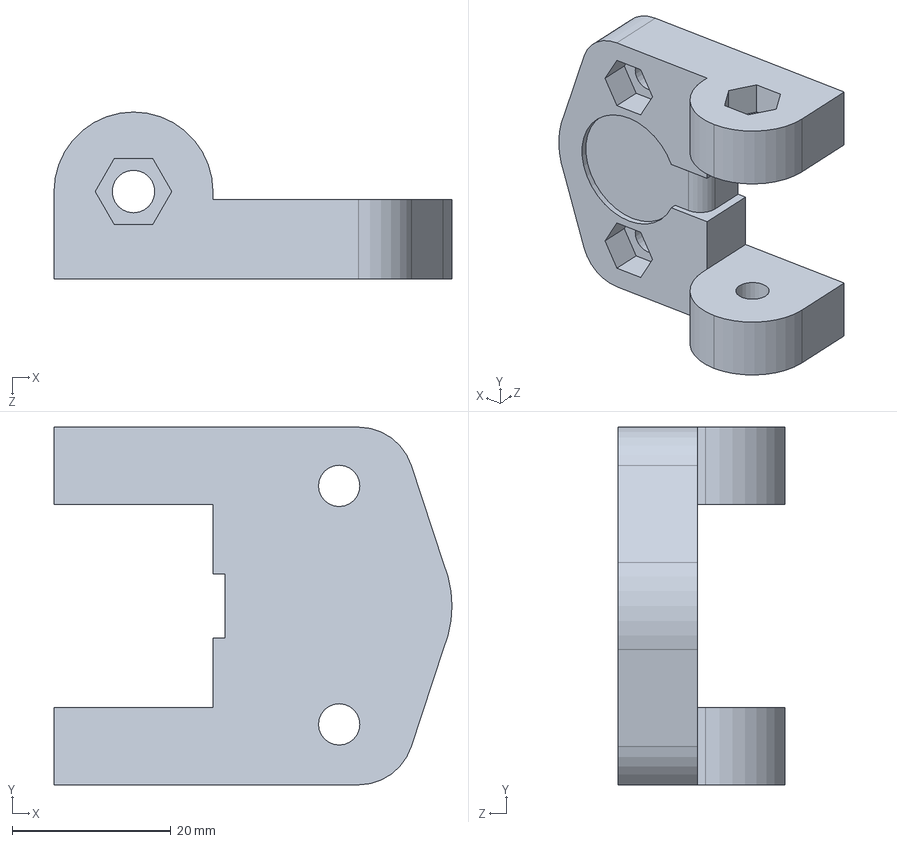
[picture p37: CAD file, 2015-06-23]
glass hold down/P-GL-001_REV_0.SLDPRT
50.1 x 45.0 x 21.0 mm
