deltagreg/OPEN-DELTA/POWER SUPPLY/P-PS-005_REV_0.SLDPRT

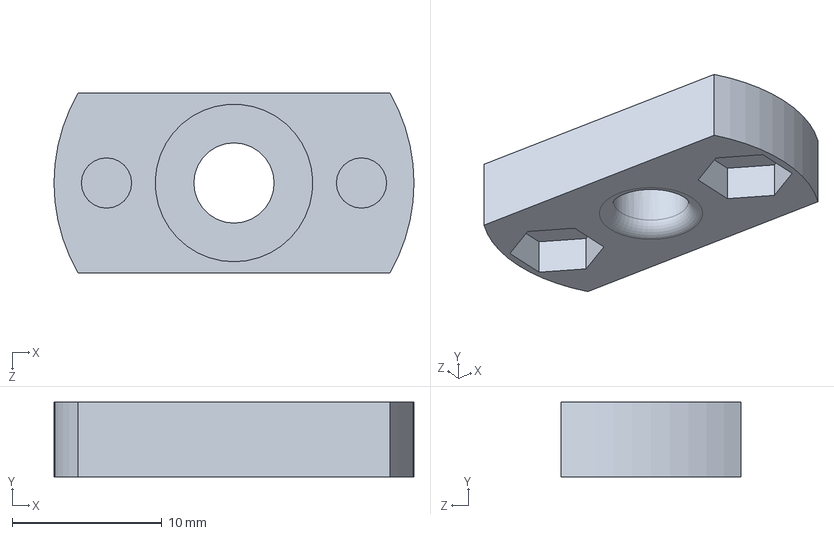
[picture p38: CAD file, 2015-06-23]
POWER SUPPLY/P-PS-005_REV_0.SLDPRT
24.0 x 5.00 x 12.0 mm
