deltagreg/OPEN-DELTA/linear rail/P-LR-003_REV_0.SLDPRT

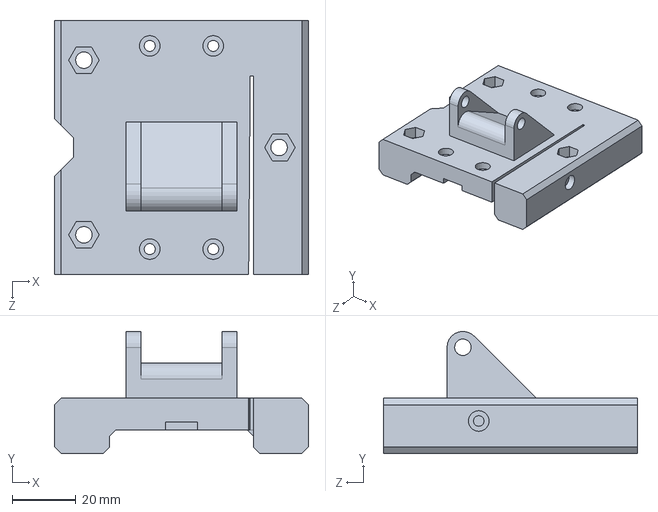
[picture p39: CAD file, 2015-06-23]
linear rail/P-LR-003_REV_0.SLDPRT
80.0 x 38.5 x 80.0 mm
