deltagreg/OPEN-DELTA/POWER SUPPLY/P-PS-002_REV_0.SLDPRT

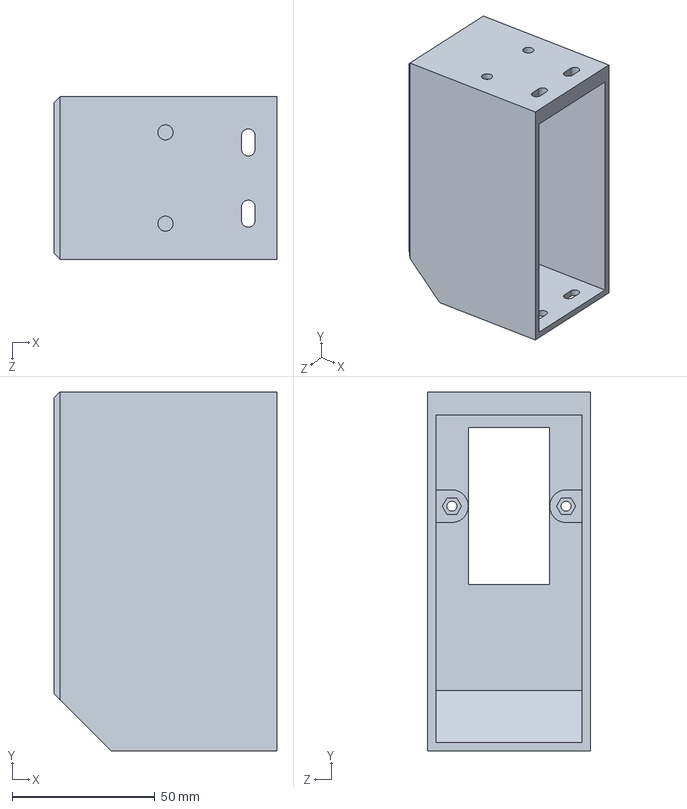
[picture p40: CAD file, 2015-06-23]
POWER SUPPLY/P-PS-002_REV_0.SLDPRT
78.0 x 125.8 x 57.0 mm
