deltagreg/OPEN-DELTA/linear rail/P-LR-005_REV_0.SLDPRT

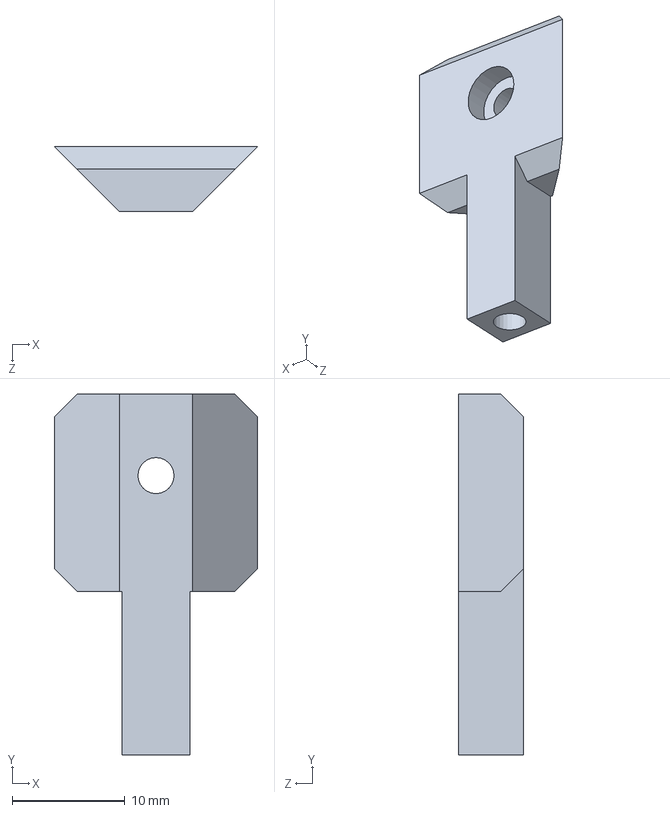
[picture p41: CAD file, 2015-06-23]
linear rail/P-LR-005_REV_0.SLDPRT
18.0 x 32.0 x 5.75 mm
