deltagreg/OPEN-DELTA/linear rail/P-LR-004_REV_0.SLDPRT

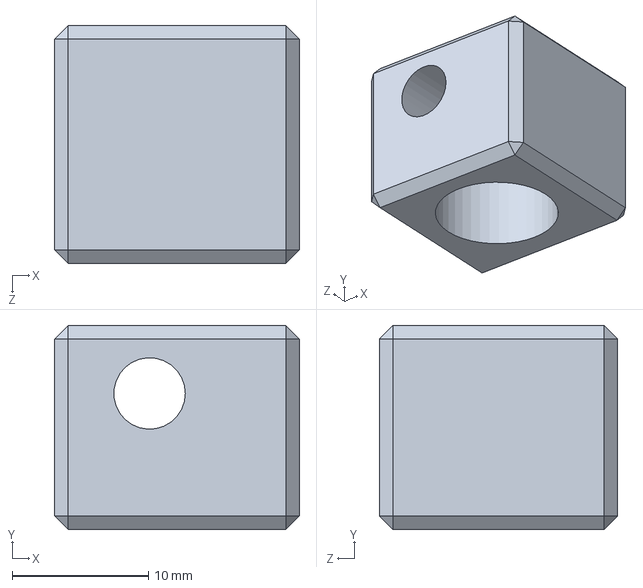
[picture p42: CAD file, 2015-06-23]
linear rail/P-LR-004_REV_0.SLDPRT
18.0 x 15.0 x 17.5 mm
