deltagreg/OPEN-DELTA/frame/P-FM-001_REV_0.SLDPRT

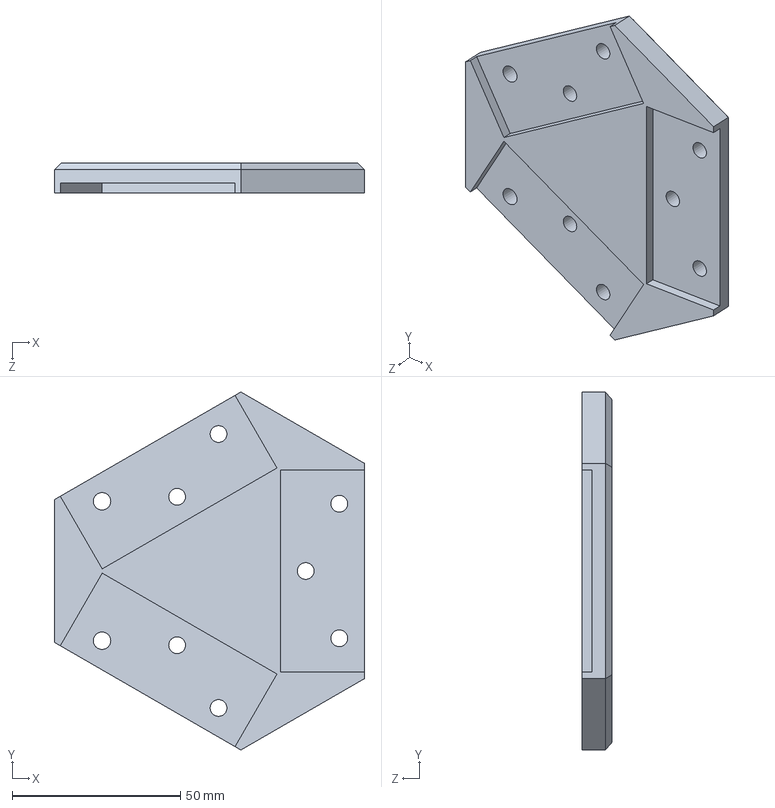
[picture p43: CAD file, 2015-06-23]
frame/P-FM-001_REV_0.SLDPRT
92.2 x 106.5 x 9.00 mm
