deltagreg/OPEN-DELTA/(list of files, cad)

Other CAD files:
frame/M-FM-003_REV_0.dwg
LASER CUT/L-SD-003_REV_0.dwg
printer dwg/delta thankgiving rev 125_REV9.dwg
rods/M-AM-001_REV_0.dwg
belt guard/P-BG-001_REV_0.SLDPRT
END STOP/E-HE-002_REV_0.dwg
frame/M-FM-004_REV_0.dwg
LASER CUT/L-SD-011_REV_0.dwg
wire duct/P-HP-002_REV_0.SLDPRT
frame/M-FM-001_REV_0.dwg
LASER CUT/L-SD-001_REV_0.dwg
linear rail/M-LR-001_REV_0.dwg
PUSHER/P-FF-001_REV_0.SLDPRT
LASER CUT/L-SD-020_REV_0.dwg
linear rail/M-LR-002_REV_0.dwg
frame/M-FM-006_REV_0.dwg
LASER CUT/L-SD-002_REV_0.dwg
frame/M-FM-005_REV_0.dwg
LASER CUT/L-SD-012_REV_0.dwg
frame/M-FM-002_REV_0.dwg
LASER CUT/L-SD-010_REV_0.dwg
linear rail/P-LR-001_REV_0.SLDPRT
END STOP/P-HS-01_REV_0.STL
POWER SUPPLY/OLD/P-PS-003_REV_0.SLDPRT
POWER SUPPLY/OLD/P-PS-003_REV_0.STL
POWER SUPPLY/P-PS-001_REV_0.STL
POWER SUPPLY/P-PS-002_REV_0.STL
POWER SUPPLY/P-PS-003_REV_0.STL
POWER SUPPLY/P-PS-004_REV_0.STL
POWER SUPPLY/P-PS-005_REV_0.STL
PUSHER/P-FF-001_REV_0.STL
PUSHER/P-FF-002_REV_0.STL
PUSHER/P-FF-003_REV_0.STL
belt guard/P-BG-001_REV_0.STL
belt guard/P-BG-002_REV_0.STL
display/P-DS-001_REV_0.STL
display/P-DS-002_REV_0.STL
frame/P-FM-001_REV_0.STL
frame/P-FM-002_REV_0.STL
glass hold down/P-GL-001_REV_0.STL
glass hold down/P-GL-002_REV_0.STL
glass hold down/P-GL-003_REV_0.STL
linear rail/P-LR-001_REV_0.STL
linear rail/P-LR-002_REV_0.STL
linear rail/P-LR-003_REV_0.STL
linear rail/P-LR-004_REV_0.STL
linear rail/P-LR-005_REV_0.STL
linear rail/P-LR-006_REV_0.STL
planchette/P-PL-001_REV_0.STL
planchette/P-PL-002_REV_0.SLDPRT
planchette/P-PL-002_REV_0.STL
planchette/P-PL-002_REV_1.STL
reel post/P-RH-001_REV_0.STL
rods/P-AM-01_REV_0.STL
switch box/P-PR-001_REV_0.STL
