deltagreg/OPEN-DELTA/photos/3D Printer 045.JPG

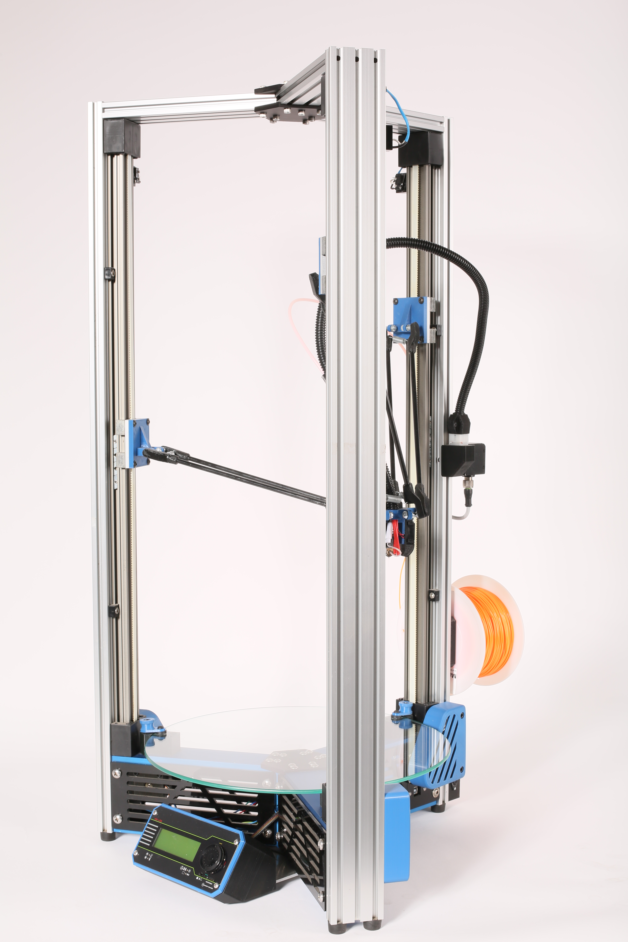
photos/3D Printer 045.JPG
