deltagreg/OPEN-DELTA/photos/3D Printer 046.JPG

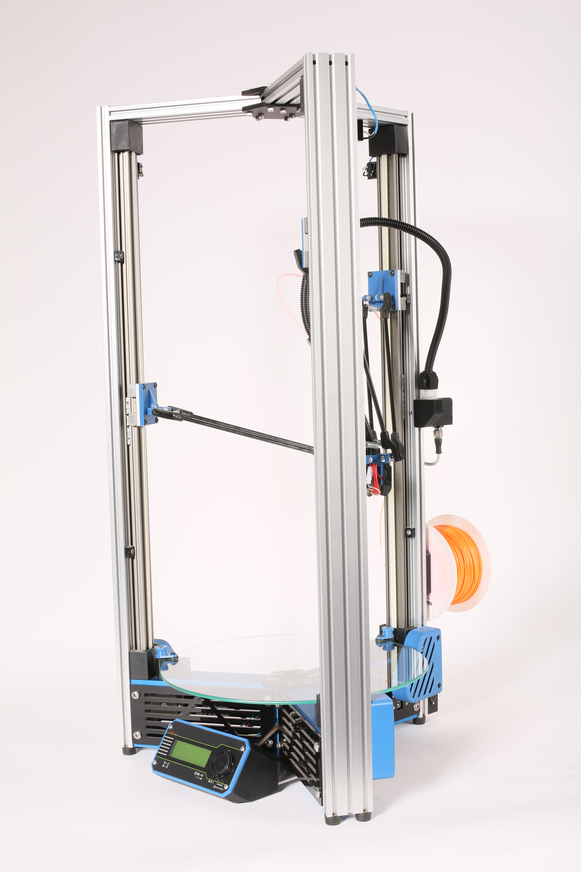
photos/3D Printer 046.JPG
