deltagreg/OPEN-DELTA/photos/3D Printer 047.JPG

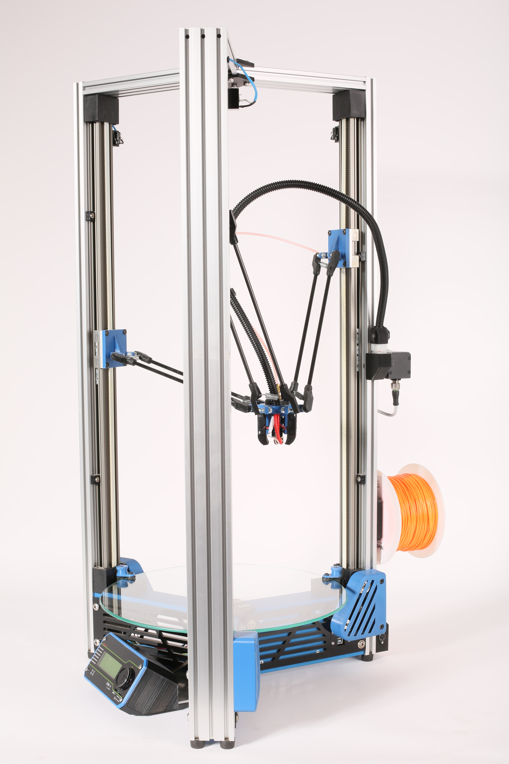
photos/3D Printer 047.JPG
