deltagreg/OPEN-DELTA/photos/3D Printer 048.JPG

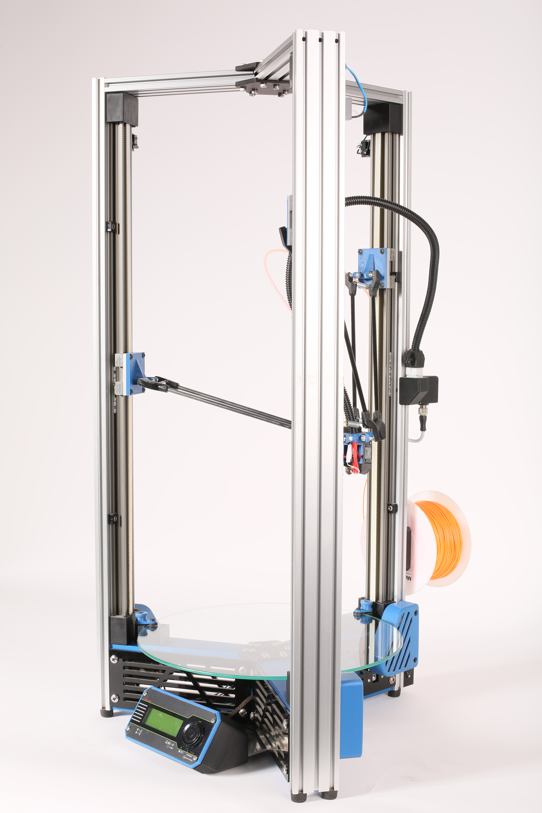
photos/3D Printer 048.JPG
