deltagreg/OPEN-DELTA/photos/3D Printer 049.JPG

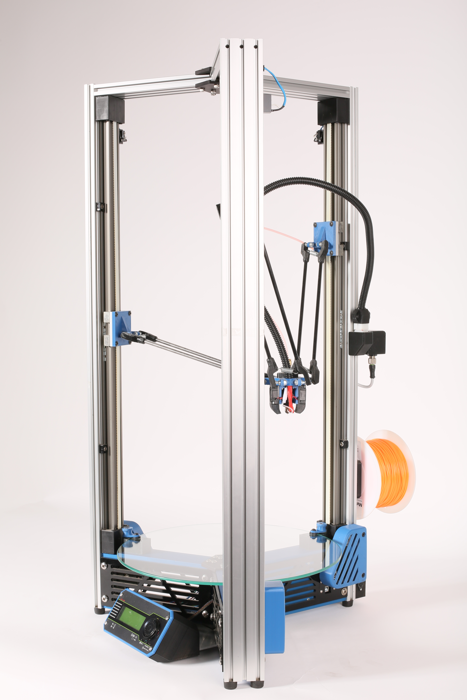
photos/3D Printer 049.JPG
