deltagreg/OPEN-DELTA/photos/3D Printer 050.JPG

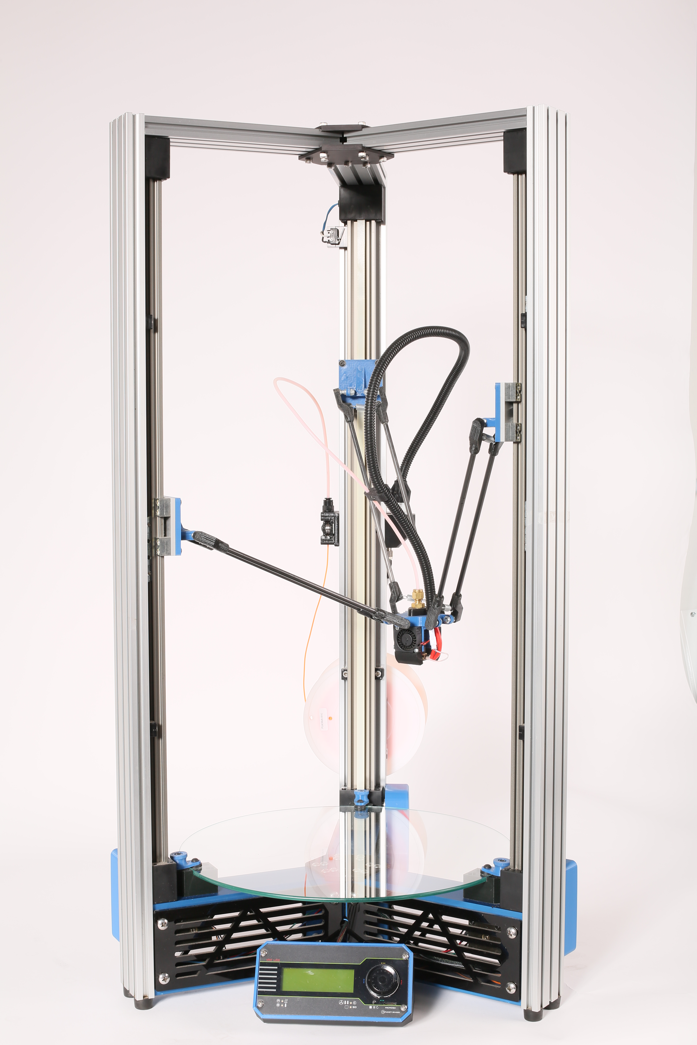
photos/3D Printer 050.JPG
