deltagreg/OPEN-DELTA/photos/3D Printer 051.JPG

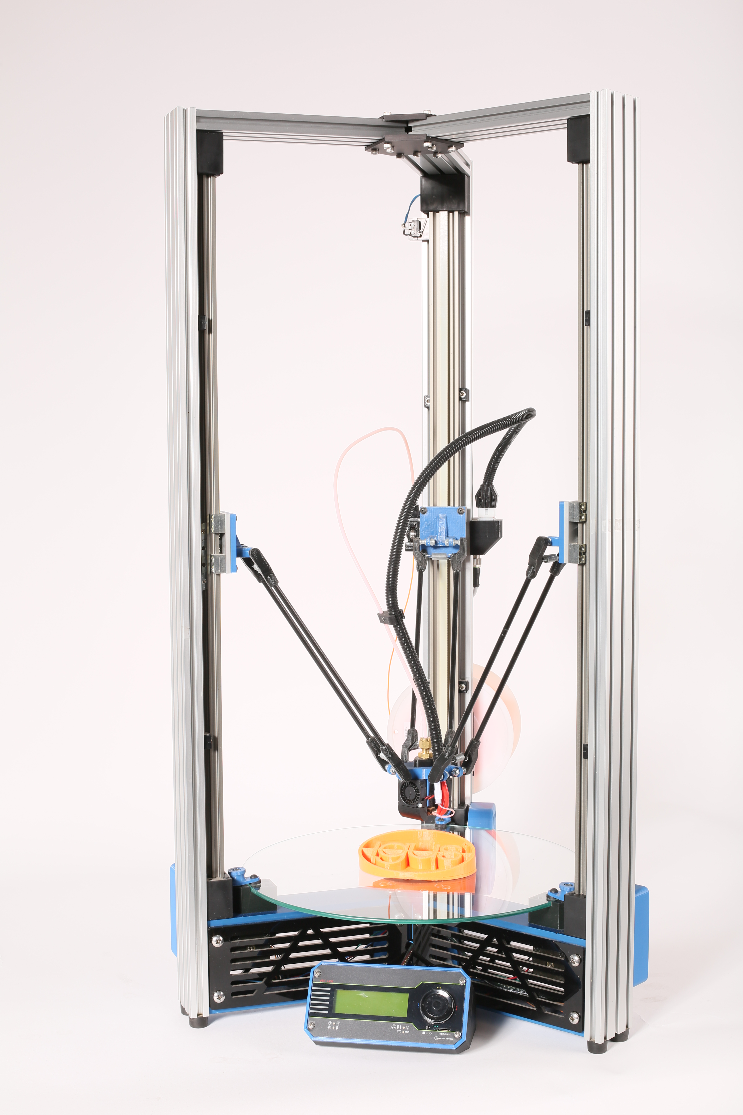
photos/3D Printer 051.JPG
