deltagreg/OPEN-DELTA/photos/3D Printer 055.JPG

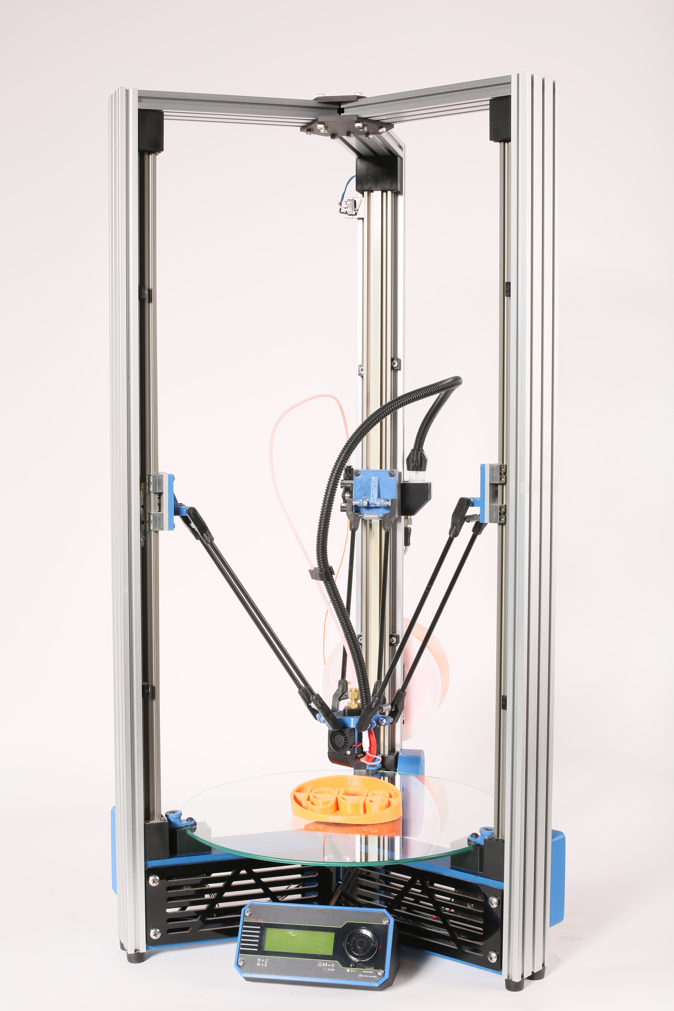
photos/3D Printer 055.JPG
