deltagreg/OPEN-DELTA/(commit log)

2015-06-23 bill of material
    [OPEN SOURCE PRINTER REV_0.xls]
2015-06-23 adding another file
    [controller boards.xls]
2015-06-23 rev 0 dump
    [Assem1.SLDASM, E-HE-002_REV_0.dwg, FF-ASSY.SLDASM, L-SD-001_REV_0.dwg, L-SD-002_REV_0.dwg, L-SD-003_REV_0.dwg, L-SD-010_REV_0.dwg, L-SD-011_REV_0.dwg]
2015-06-30 modified P-pl_002
    thicker walls and rib to make stronger
    [OPEN SOURCE PRINTER REV_1.xls, P-PL-002_REV_1.SLDPRT, P-PL-002_REV_1.STL]
